KPI-Rover/rpi-power-hat/doc/rpi-power-hat.jpg

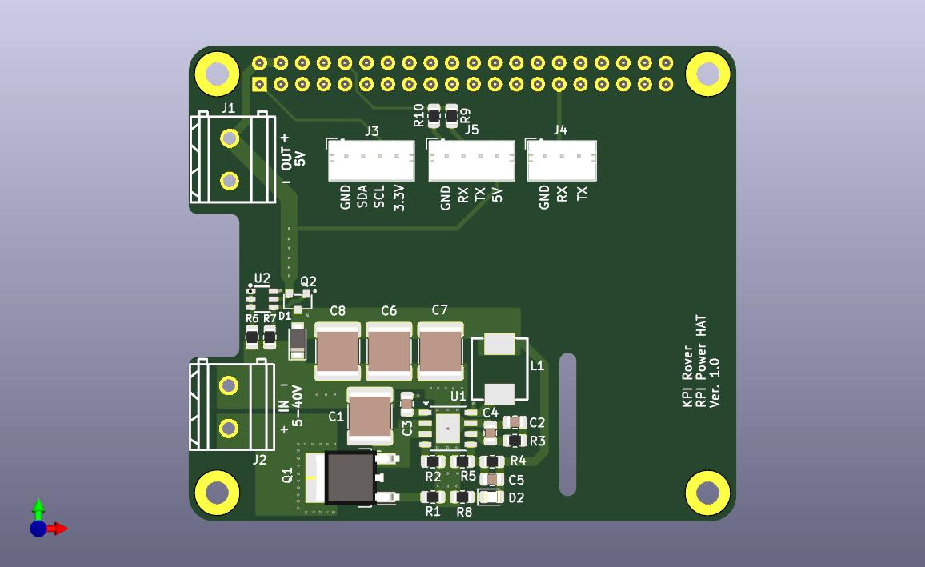
doc/rpi-power-hat.jpg
