KPI-Rover/rpi-power-hat/README.md

# RPI Power HAT

**In development! Not verified!**
board_v_1_2
