KPI-Rover/rpi-power-hat/fabrication/KPI-Rover_RPI_Power_HAT_schematic.pdf

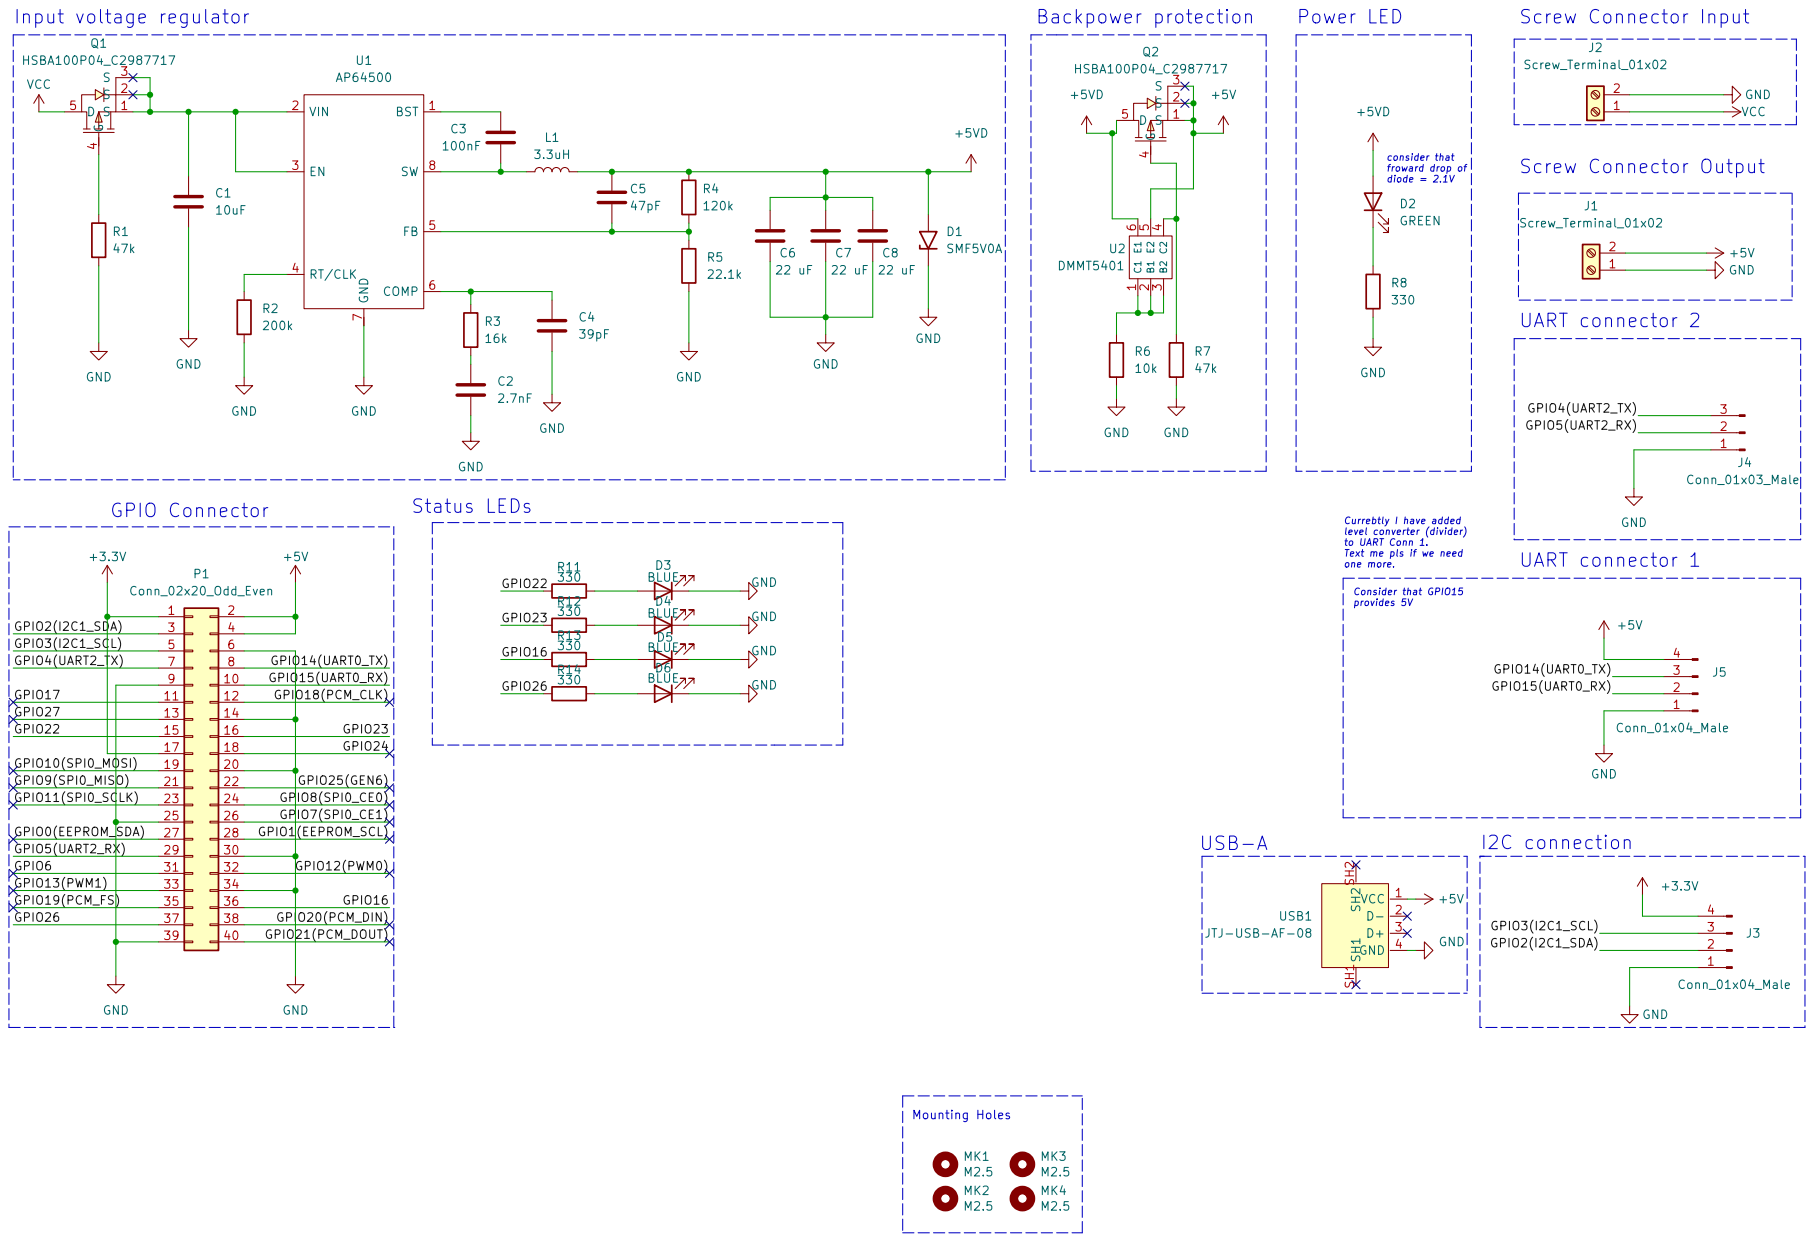
[picture p2: page 1]
