KPI-Rover/rpi-power-hat/kicad/dcdchat.kicad_pcb

## KiCad design kicad/dcdchat.kicad_pcb (2025-07-01)

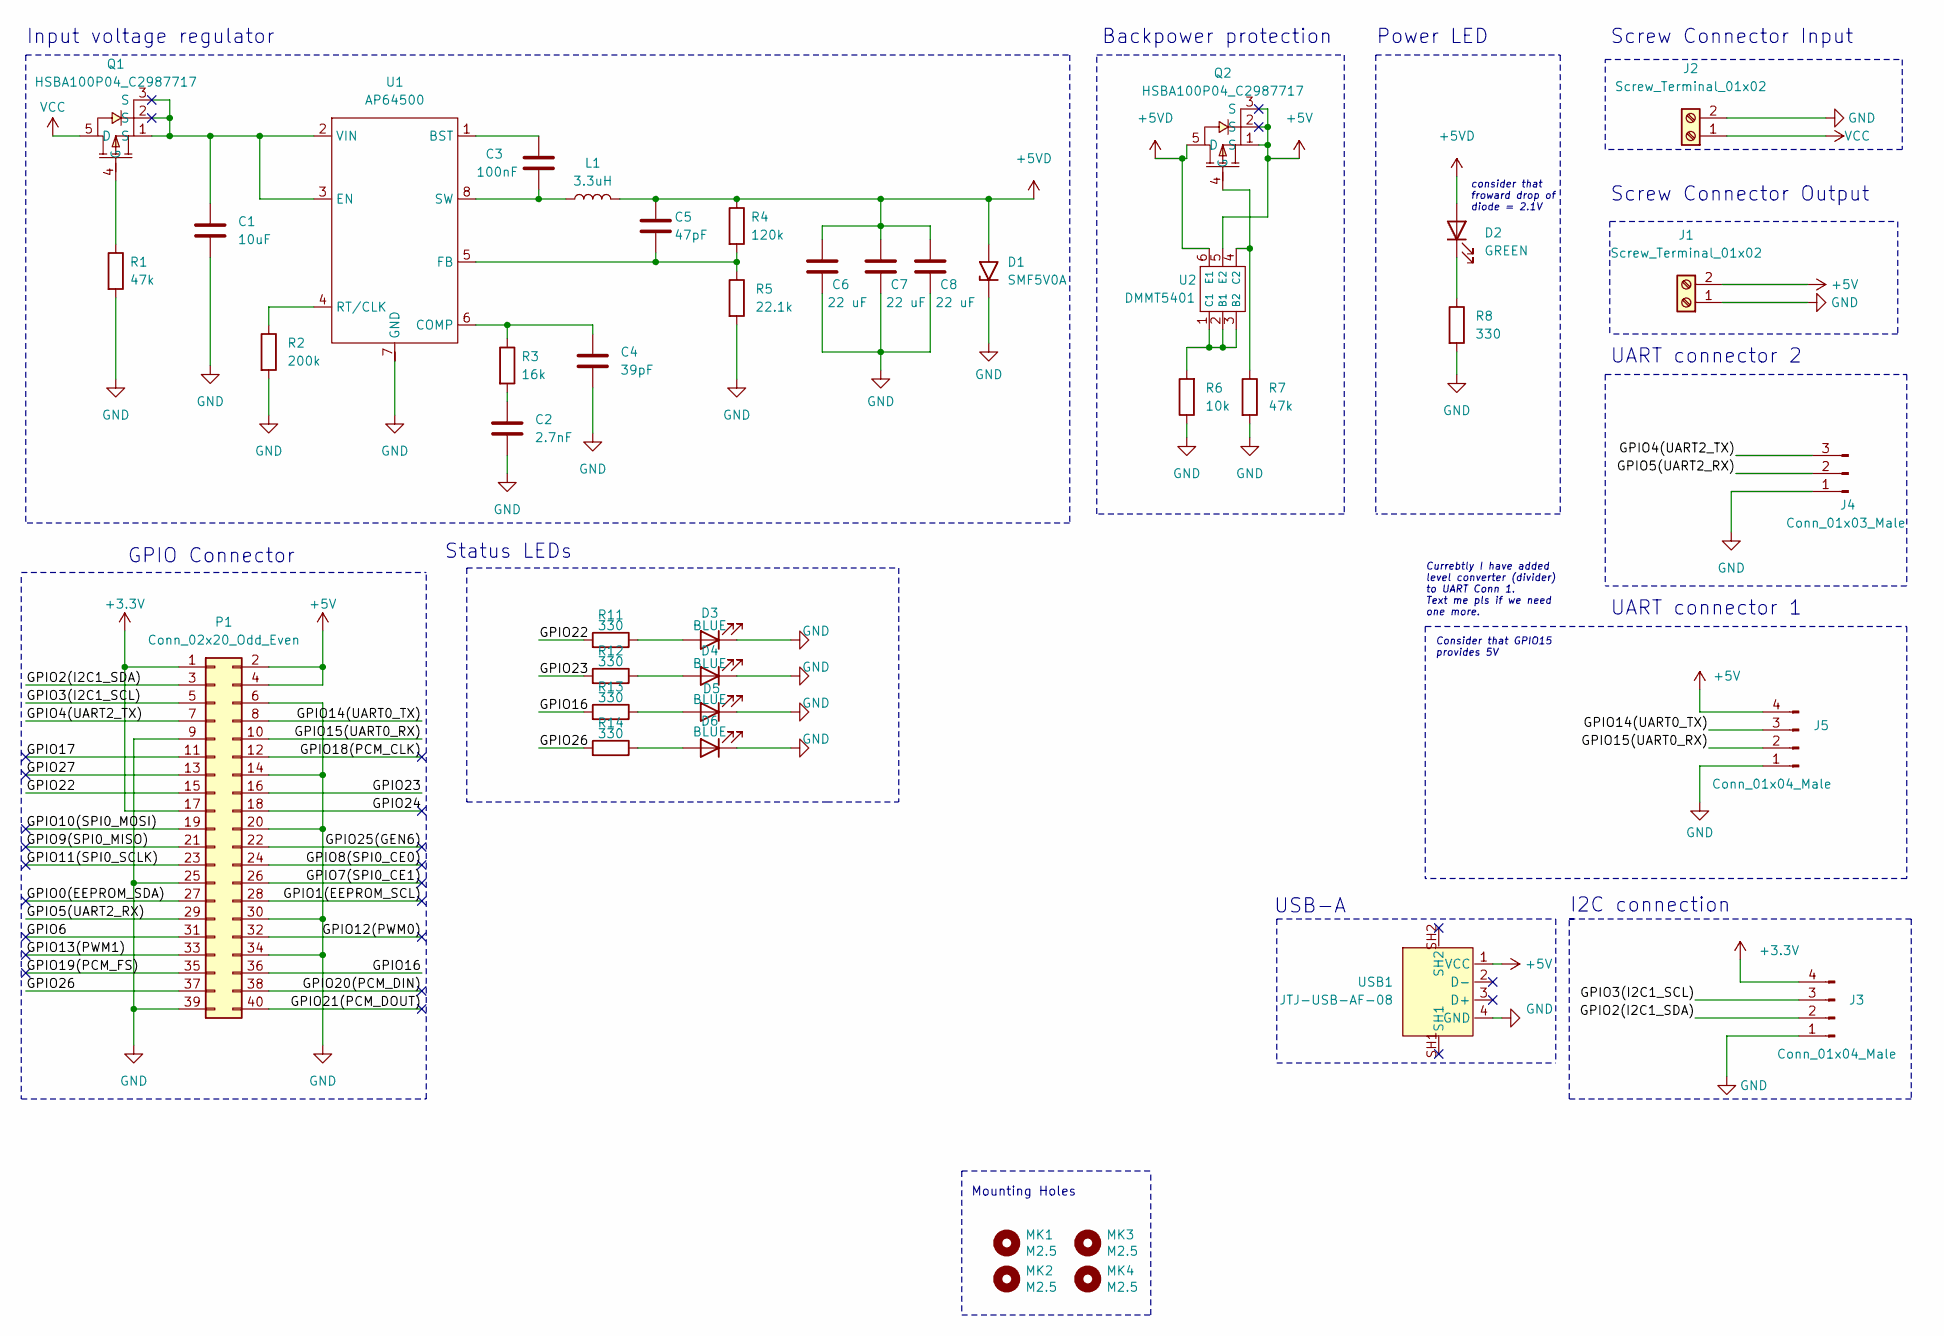
[picture p3: schematic dcdchat.kicad_sch, RPI Power HAT]

Parts:
C1: 10uF; C_1206_3216Metric; LCSC C13585
C2: 2.7nF; C_0805_2012Metric; LCSC C2918070
C3: 100nF; C_0805_2012Metric; LCSC C28233
C4: 39pF; C_0805_2012Metric; LCSC C576897
C5: 47pF; C_0805_2012Metric; LCSC C113821
C6, C7, C8: 22 uF; C_1206_3216Metric; LCSC C87996
D1: SMF5V0A; D_SMF; LCSC C42387343
D2: GREEN; LED_0805_2012Metric; LCSC C5875740
D3, D4, D5, D6: BLUE; LED_0805_2012Metric; LCSC C965817
J1, J2: Screw_Terminal_01x02; CONN-TH_2P-P5.08; LCSC C3018698
J3, J5: Conn_01x04_Male; JST_PH_B4B-PH-K_1x04_P2.00mm_Vertical; LCSC C131334
J4: Conn_01x03_Male; JST_PH_B3B-PH-K_1x03_P2.00mm_Vertical; LCSC C131339
L1: 3.3uH; IND-SMD_L11.6-W10.1; LCSC C7587741
MK1, MK2, MK3, MK4: M2.5; MountingHole_2.7mm_M2.5_Pad
P1: Conn_02x20_Odd_Even; PinSocket_2x20_P2.54mm_Vertical; Manufacturer_Part_Number C50982; LCSC C50982
Q1, Q2: HSBA100P04_C2987717; DFN-8_L5.7-W5.1-P1.27-LS6.1-BL-1; LCSC Part C2987717
R1, R7: 47k; R_0805_2012Metric; LCSC C2989281
R2: 200k; R_0805_2012Metric; LCSC C728645
R3: 16k; R_0805_2012Metric; LCSC C865809
R4: 120k; R_0805_2012Metric; LCSC C103948
R5: 22.1k; R_0805_2012Metric; LCSC C2692772
R6: 10k; R_0805_2012Metric; LCSC C110775
R8, R11, R12, R13, R14: 330; R_0805_2012Metric; LCSC C2989109
U1: AP64500; AP64500SP-13; LCSC C2070920
U2: DMMT5401; SOT-23-6; LCSC C154733
USB1: JTJ-USB-AF-08; USB-A-TH__USB-AF-90; LCSC Part C2345

Connections:
+3.3V: J3.4, P1.1, P1.17
+5V: J1.2, J5.4, P1.2, P1.4, Q2.1 (S), Q2.2 (S), Q2.3 (S), U2.5 (E2), USB1.1 (VCC)
+5VD: C5.1, C6.1, C7.1, C8.1, D1.2 (A2), D2.2 (A), L1.2, Q2.5 (D), R4.1, U2.6 (E1)
/GPIO0(EEPROM_SDA): P1.27
/GPIO1(EEPROM_SCL): P1.28
/GPIO2(I2C1_SDA): J3.2, P1.3
/GPIO3(I2C1_SCL): J3.3, P1.5
/GPIO4(UART2_TX): J4.3, P1.7
/GPIO5(UART2_RX): J4.2, P1.29
/GPIO6: P1.31
/GPIO7(SPI0_CE1): P1.26
/GPIO8(SPI0_CE0): P1.24
/GPIO9(SPI0_MISO): P1.21
/GPIO10(SPI0_MOSI): P1.19
/GPIO11(SPI0_SCLK): P1.23
/GPIO12(PWM0): P1.32
/GPIO13(PWM1): P1.33
/GPIO14(UART0_TX): J5.3, P1.8
/GPIO15(UART0_RX): J5.2, P1.10
/GPIO16: P1.36, R13.2
/GPIO17: P1.11
/GPIO18(PCM_CLK): P1.12
/GPIO19(PCM_FS): P1.35
/GPIO20(PCM_DIN): P1.38
/GPIO21(PCM_DOUT): P1.40
/GPIO22: P1.15, R11.2
/GPIO23: P1.16, R12.2
/GPIO24: P1.18
/GPIO25(GEN6): P1.22
/GPIO26: P1.37, R14.2
/GPIO27: P1.13
GND: C1.2, C2.2, C4.2, C6.2, C7.2, C8.2, D1.1 (A1), D3.1 (K), D4.1 (K), D5.1 (K), D6.1 (K), J1.1, J2.2, J3.1, J4.1, J5.1, P1.6, P1.9, P1.14, P1.20, P1.25, P1.30, P1.34, P1.39, R1.2, R2.2, R5.2, R6.1, R7.2, R8.2, U1.7 (GND), U1.EPAD, USB1.4 (GND)
unnamed: C2.1, R3.2
unnamed: D2.1 (K), R8.1
unnamed: D3.2 (A), R11.1
unnamed: D4.2 (A), R12.1
unnamed: D5.2 (A), R13.1
unnamed: D6.2 (A), R14.1
unnamed: Q1.4 (G), R1.1
unnamed: Q2.4 (G), R7.1, U2.4 (C2)
unnamed: C3.1, U1.1 (BST)
unnamed: C4.1, R3.1, U1.6 (COMP)
unnamed: C5.2, R4.2, R5.1, U1.5 (FB)
unnamed: R2.1, U1.4 (RT/CLK)
unnamed: C3.2, L1.1, U1.8 (SW)
unnamed: R6.2, U2.1 (C1), U2.2 (B1), U2.3 (B2)
VCC: J2.1, Q1.5 (D)

Notes on the sheet:
USB-A
Currebtly I have added level converter (divider) to UART Conn 1. Text me pls if we need one more.
Backpower protection
Mounting Holes
I2C connection
GPIO Connector
UART connector 2
Status LEDs
Consider that GPIO15 provides 5V
consider that froward drop of diode = 2.1V
Screw Connector Output
Input voltage regulator
UART connector 1
Power LED
Screw Connector Input

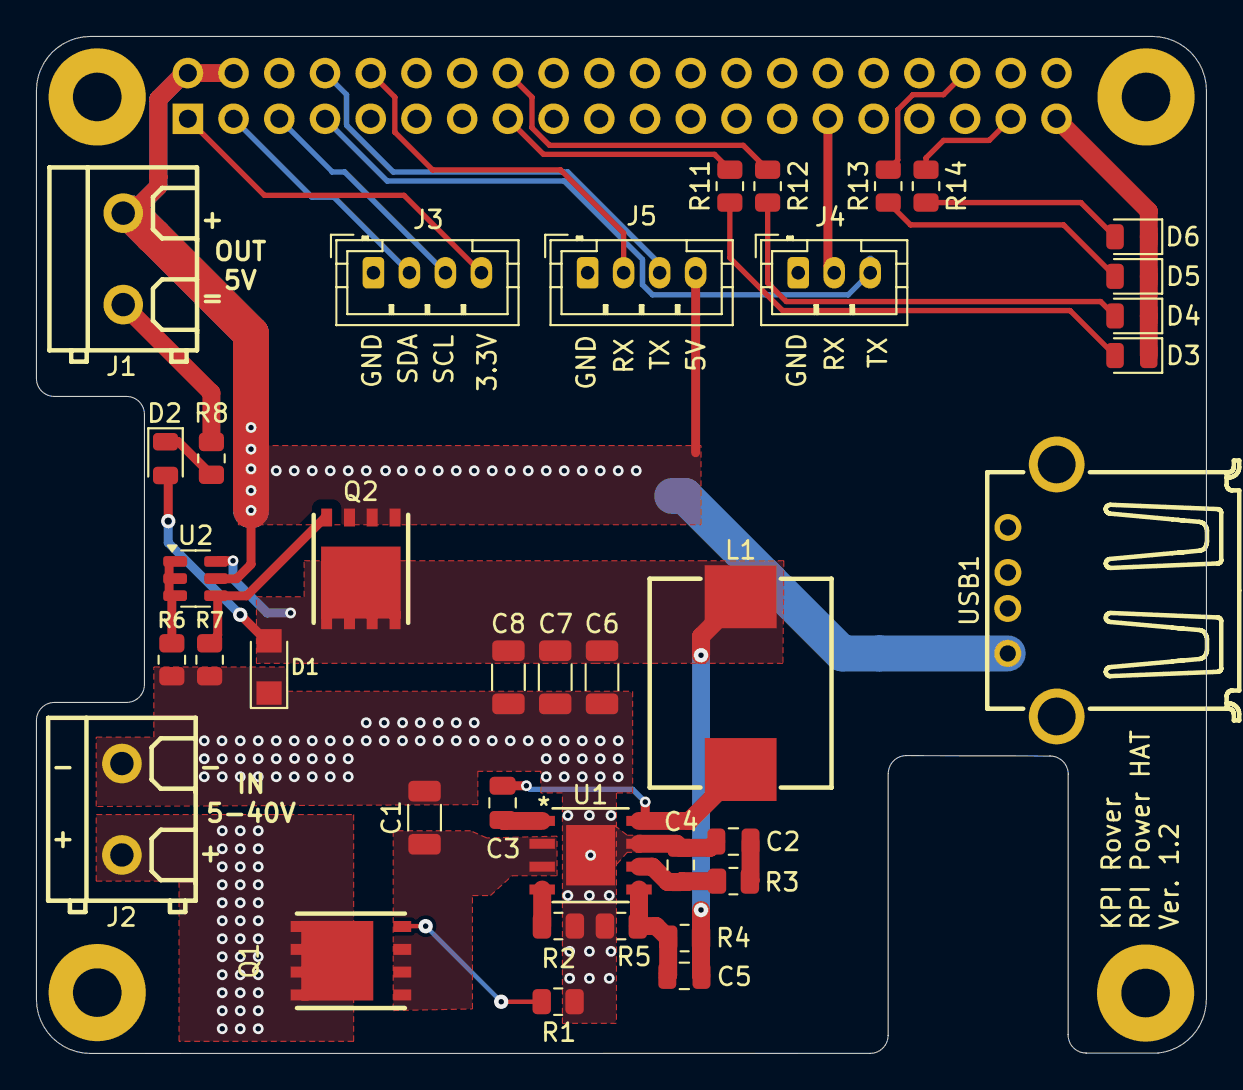
[picture p4: board dcdchat.kicad_pcb from above]

Board: 2 copper layers, 65.0 x 56.5 mm, 42 parts (1 on the bottom side), 29 nets.
