KPI-Rover/rpi-power-hat/(threads)

Thread 1 (2024-11-03):

Develop a power supply board for the Raspberry Pi 5.

AksonovSergei, 2024-11-03:
A power supply board for the Raspberry Pi and sensor connections must be developed.
Requirements for the board can be found here: [doc/requirements-rpi-power-HAT.md](./doc/requirements-rpi-power-HAT.md)

AksonovSergei, 2025-01-21:
One board has been mounted and tested with a 1A load.
Everything looks fine—no heating at all, and the output voltage ripple is less than 10mV.
After reading the datasheet more carefully, it was found that capacitors C4 and C5 are not necessary. They were removed and tested without them, and there were no changes in performance.

Improvements for the next version:
- [ ]  Remove capacitors C4 and C5.
- [ ]  Replace capacitor C1 (10µF) with a 22µF capacitor like C6, C7, and C8 to reduce the number of different parts in the BOM.
- [ ]  Replace connectors J1 and J2 with smaller ones, maybe JST.
- [ ]  Consider using an SMD 40-pin Raspberry Pi header.
- [ ]  Add an SPI interface.
- [ ]  Add outputs connected to GPIO with open-drain configuration.

The final testing with the maximum load of 5A will be done soon, once the 100W load resistors arrive.

AksonovSergei, 2025-02-09:
Testing with 5A load was done.
Board was working for load 5A during 1 hour with no problem.
During test it was found that temperature of inductor is to high (more then 70*C). It was expected since we selected wrong one.

Closed 2025-02-09.

Thread 2 (2025-02-09):

Fix comments and implement suggestions identified during the production of version 1.0

AksonovSergei, 2025-02-09:
We need to make changes to the design based on the first prototype bring-up. The following issues were identified:
- [x]  Replace capacitor C6, C7, and C8 with voltage 10V instead of 50 - C87996
- [x]  Replace connectors J1 and J2 with smaller ones - C918120
- [x]  Add 4 blue SMD leds to indicate status of RPI - C965817
- [x] Replace MOSFETs Q1 and Q2 with ones having a lower RDS value - C2987717
- [x] Place D2 and R8 after C6-C8 capacitors.
- [x] Replace L1 with one having a higher Current Rating and Current - Saturation C7587741
- [x] Make window for camera cables like Raspberry Pi SSD Kit has https://www.raspberrypi.com/products/ssd-kit/
- [x] Change R10 value to 20kOm
- [x] Add USB - C2345

Initial requirements: https://kpi-rover.github.io/docs/platform/rpi_power_hat/requirements
Should be updated in scope of this task.

Please take to account:
1. All components must be available to purchase on https://www.lcsc.com/.
2. All schematic components must have the field LCSC that should contain LCSC Part Number. This field will be used to generate order list.

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

AksonovSergei, 2025-03-02:
Hi @Ryabokon-Varya,
How's it going?
I see you have marked as done two check boxes - super. I have created branch for this task (2-improvements). Please push you changes.
If you have any questions or need support, please ask in this task.

AksonovSergei, 2025-03-08:
Hi @Ryabokon-Varya,
Thank you very much for your effort.

Which KiCAD version are you using? Is it version 9? If not, please update to version 9.

I think it would be better to move the comments you added to the README into the task.

Looking forward to more updates!

Ryabokon-Varya, 2025-04-10:
Hi @AksonovSergei ,
I’ve updated KiCAD to version 9 as requested.
Additionally, I’ve made some other improvements during the process. Please let me know if everything looks good, and if you spot anything that needs further adjustment or clarification.

Thank you for your time and feedback!

Ryabokon-Varya, 2025-05-15:
Hi @AksonovSergei ,
I’ve finished the final improvements to the board and pushed them.

If there’s anything else you need, or if you have any feedback, please let me know!

Closed 2025-05-25.

Thread 4 (2025-06-12):

Version 1.2

AksonovSergei, 2025-06-12:
I have soldered one PCB version 1.1. The following should be changed based on it.

- [x] Remove Q3 and connect blue LEDs directly to RPI thru resistor 330 Ohm
The IC MMPQ3904 is out of the stocke. And according to RPI documentation we can connect load up to 15mA for each pin.
- [x] Replace J1 and J2 with C3018698
- [x] Change fot C1 footprint to 1206.
- [x] Change R8 to 330 Ohm
- [x] Remove R9 and R10
- [x] Use pin 7 of P1 instead of pin 27 as TX signal and rename UART1 to UART2

Additional fix:
Footprint of U2 changed to SOT-23-6 in the schematic

AksonovSergei, 2025-07-16:
PCB manufacture ordered and received.
