KPI-Rover/rpi-power-hat/(commit log)

2024-10-25 Add new requirements
    - Вимоги до розташування компонентів
    - Кріплення
    - Роз'єм для HC-05
2024-11-10 Added input voltage regulator, backpower protection circuit, outer device power relay schematic
    [dcdchat.kicad_pcb, dcdchat.kicad_sch]
2024-11-12 added gpio connector
    [dcdchat.kicad_sch]
2024-11-12 Added readme, added CHassis connector
    [dcdchat.kicad_sch]
2024-11-17 Fixes in pinout, deleting relay
    [dcdchat.kicad_sch]
2024-11-18 Added schematic for connector. Added diode to protect from wrong polarity . Added footprintlibrary for AP64500
    [dcdchat.kicad_sch]
2024-11-19 Added TVS-diode
    [dcdchat.kicad_sch]
2024-11-25 Added footprints for elements
    [dcdchat.kicad_sch]
2024-11-25 fixed 2, 3, 4, 5, 6 in 25.11.2024 message
    [dcdchat.kicad_sch]
2024-11-26 fixed 7, 8. Added level converter from 5v to 3.3V
    [dcdchat.kicad_sch]
2024-11-26 Added backpower protection diode BSS84 before DC-DC
    [dcdchat.kicad_sch]
2024-11-29 made changes due to 28.11.2024 message
    [dcdchat.kicad_sch]
2024-12-02 DC-DC converter elements values changes
    [dcdchat.kicad_sch]
2024-12-03 Done changes in 2.12.2024 message
    [dcdchat.kicad_sch]
2024-12-08 Assigning footprints and placing components in PCB editor
    [dcdchat.kicad_pcb]
2024-12-10 Replacing components in PCB editor due to 08.12.2024 message
    [dcdchat.kicad_pcb, dcdchat.kicad_sch]
2024-12-15 Added polygons between pins. Havent added polygons for GND and output connection yet
    [dcdchat.kicad_pcb]
2024-12-29 added traces and polygons on PCB
    [dcdchat.kicad_pcb]
2025-01-01 Finalize the PCB layout
    [dcdchat.kicad_pcb, dcdchat.kicad_sch]
2025-01-01 Clean Up
    [dcdchat.kicad_pcb, dcdchat.kicad_sch]
2025-03-08 Made improvements to schematic
    [dcdchat.kicad_sch]
2025-05-15 Final improvements
    [dcdchat.kicad_pcb, dcdchat.kicad_sch]
2025-05-25 Issue #2: Prepare for production
    [BOM_v1.1.csv, dcdchat.kicad_pcb, dcdchat.kicad_sch]
2025-07-01 Issue #4: Made improvements to board
    [dcdchat.kicad_pcb, dcdchat.kicad_sch]
2025-07-01 Issue #4: Prepare for production
    [BOM_v1.2.csv, dcdchat.kicad_sch]
